Arve2/Vibra-trickler-3/(list of files, cad)

Other CAD files:
3D-parts/Hopper-parts.stl
3D-parts/TCRT5000-blinder.stl
3D-parts/Hopper-parts.f3d
