Arve2/Vibra-trickler-3/(commit log)

2024-07-20 code.py proof of concept
    Managed to get VL ToF sensor and PWM vibrator working with CircuitPython and adafruit modules.
    [code.py]
2024-07-20 PWM DC inversely proportionate to ToF
2024-07-23 URL to CAD 3D parts
2024-07-24 No need to download adafruit_bus_device
    The module was allready included per default in CircuitPython.
2024-07-24 Setup and test function for three buttons
2024-07-24 Start+Stop buttons implemented. LED indication.
2024-07-24 Auto-start at power-on
2025-01-01 overview.jpg for two-stage design
2025-01-01 Reworking readme.md for two-stage design
2025-01-04 Image of sensors from left
2025-01-04 3D parts for hopper and TCRT5000
    [Hopper-parts.f3d, Hopper-parts.stl, TCRT5000-blinder.stl]
2025-01-04 circuit_diagram.jpg: Added sensor GND line
2025-01-04 README.md: BoM, Disclaimer, Assembly
2025-01-17 Completely reworked code for 2x IR sensors
    [code.py]
2025-01-29 Hopper with pre-made 2mm hole
    [Hopper-parts.f3d, Hopper-parts.stl]
